Dune005/raum-tracker/Dokumentation/Arbeitsprozess_Bilder/Arbeit_am_Projekt.jpg

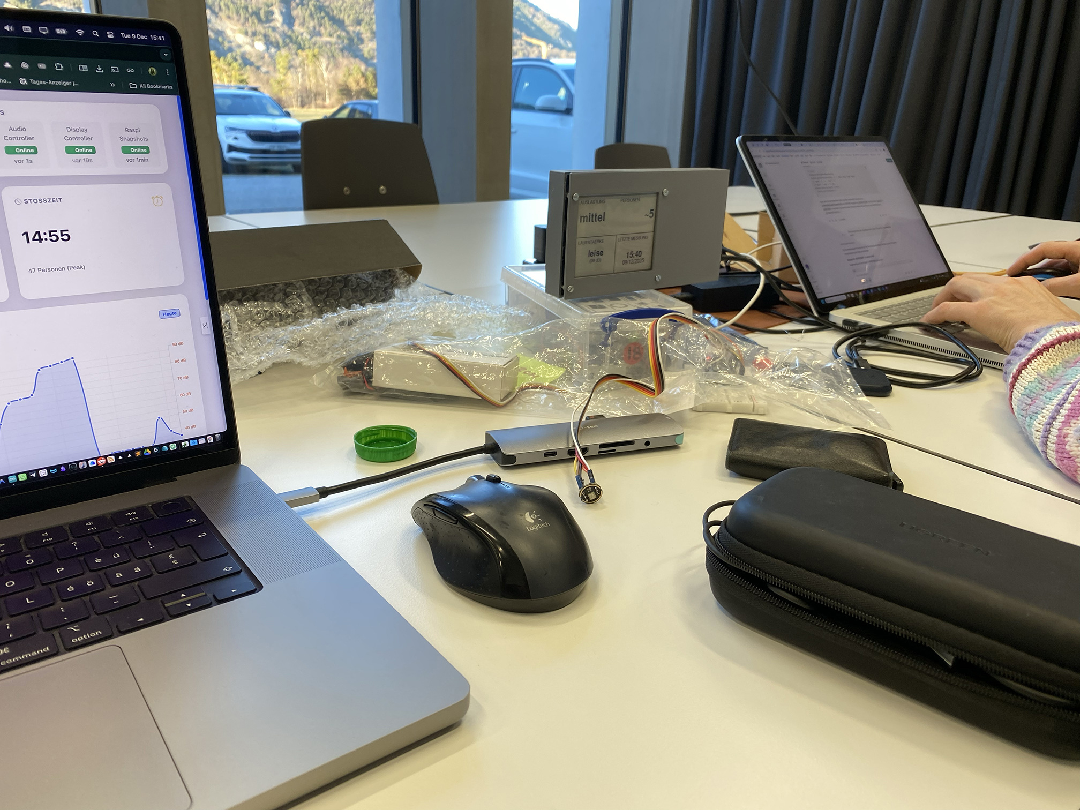
Dokumentation/Arbeitsprozess_Bilder/Arbeit_am_Projekt.jpg
