Dune005/raum-tracker/Dokumentation/Arbeitsprozess_Bilder/display1.jpeg

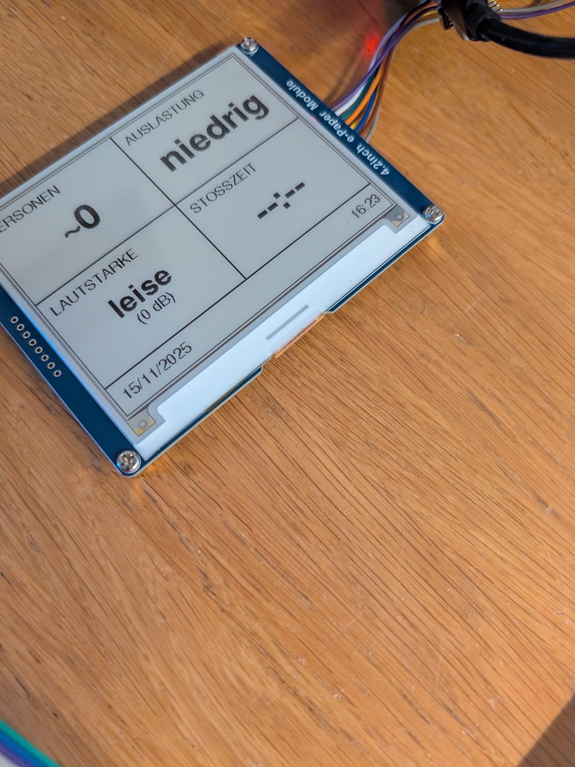
Dokumentation/Arbeitsprozess_Bilder/display1.jpeg
