Dune005/raum-tracker/Dokumentation/Arbeitsprozess_Bilder/display2.jpeg

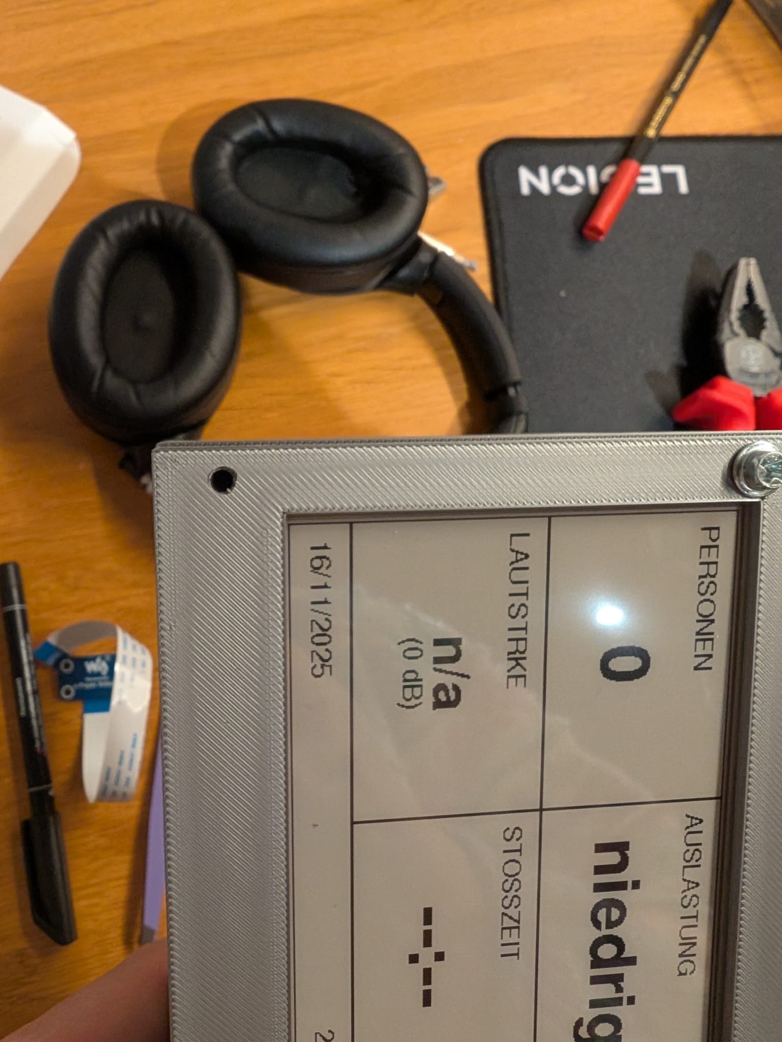
Dokumentation/Arbeitsprozess_Bilder/display2.jpeg
