Dune005/raum-tracker/Dokumentation/Arbeitsprozess_Bilder/display3.jpeg

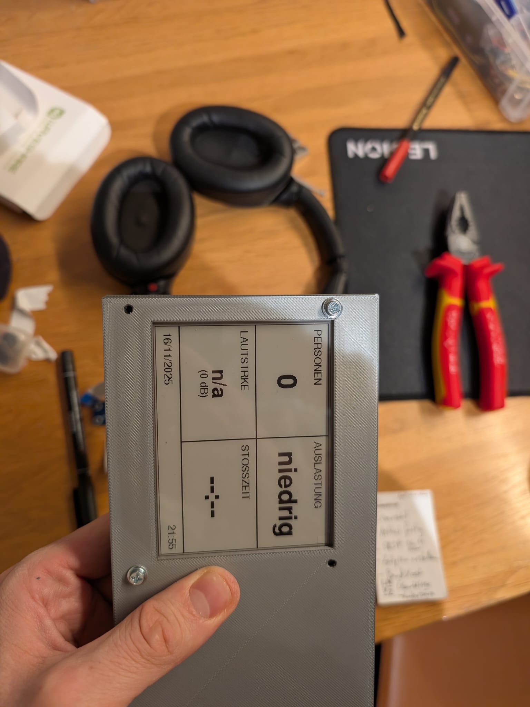
Dokumentation/Arbeitsprozess_Bilder/display3.jpeg
