Dune005/raum-tracker/Dokumentation/Arbeitsprozess_Bilder/display4.jpeg

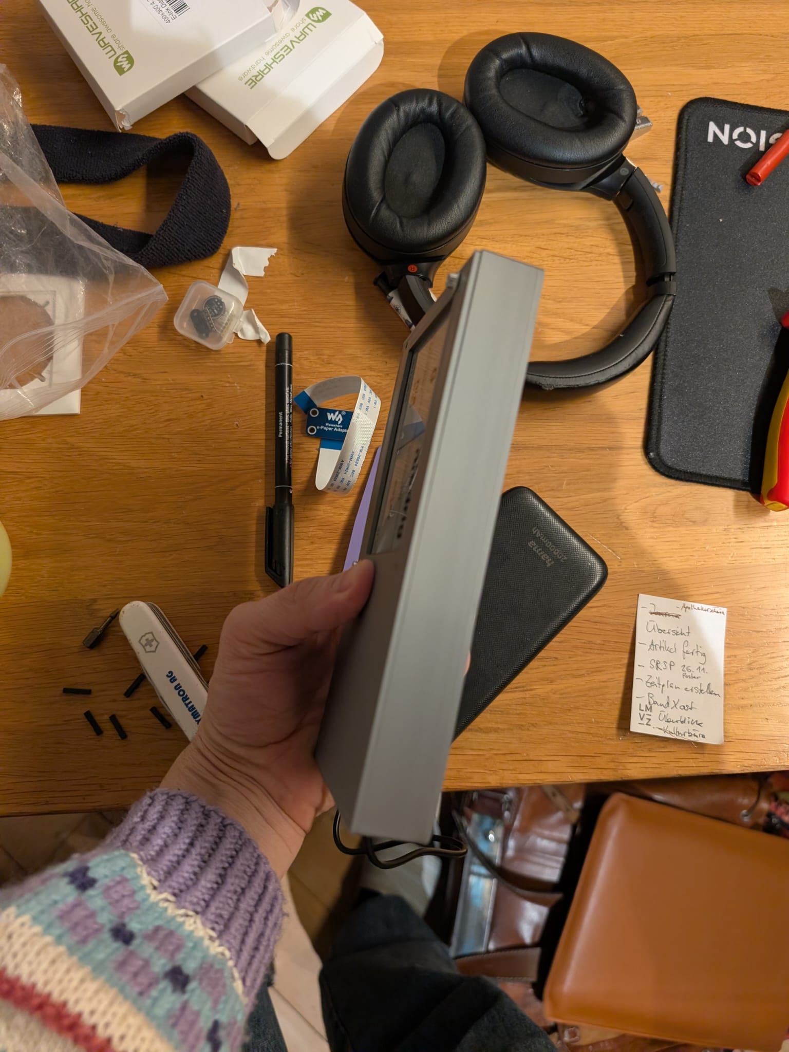
Dokumentation/Arbeitsprozess_Bilder/display4.jpeg
