Dune005/raum-tracker/Dokumentation/Arbeitsprozess_Bilder/display_COMPR.jpg

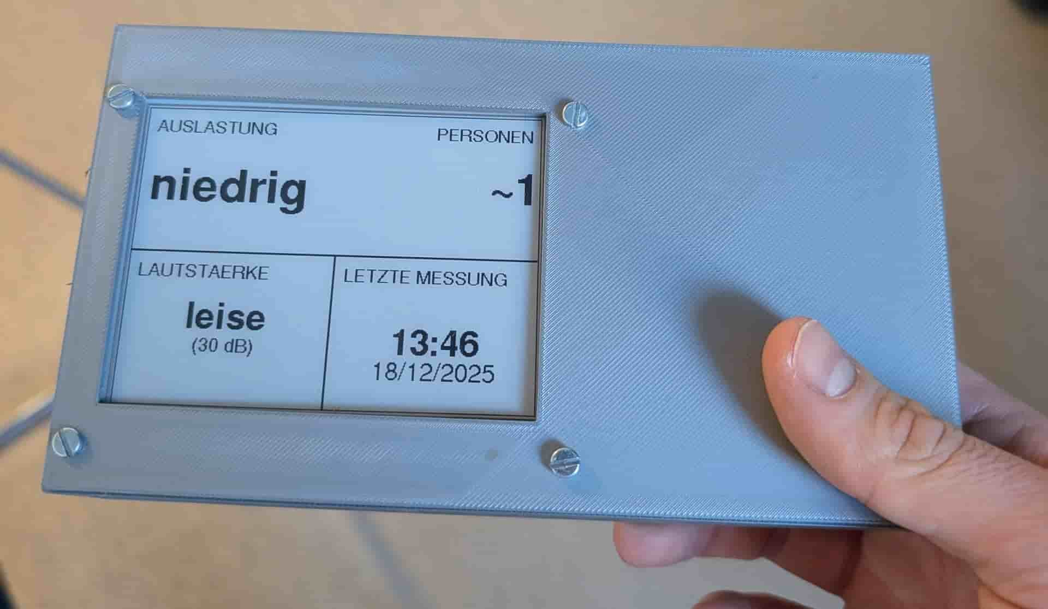
Dokumentation/Arbeitsprozess_Bilder/display_COMPR.jpg
