Dune005/raum-tracker/Dokumentation/Arbeitsprozess_Bilder/Display_IB.jpeg

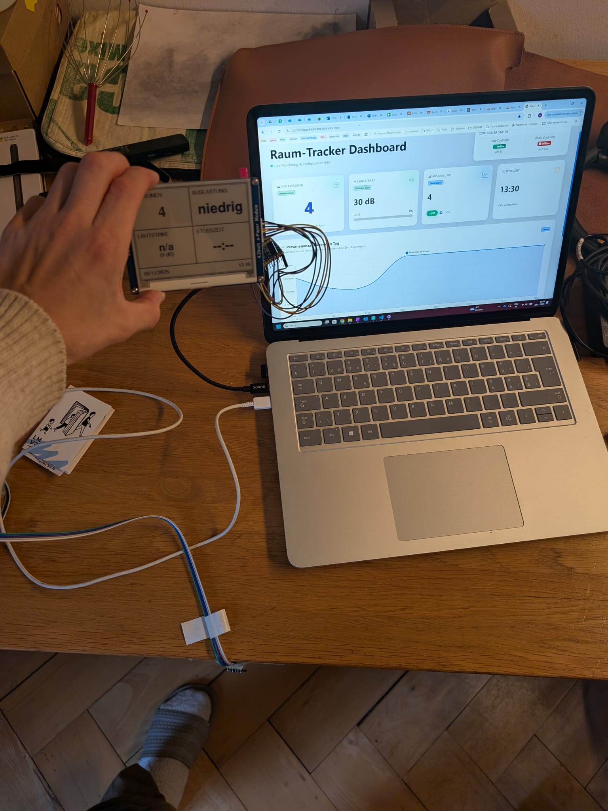
Dokumentation/Arbeitsprozess_Bilder/Display_IB.jpeg
