Dune005/raum-tracker/Dokumentation/Arbeitsprozess_Bilder/display_mit_gehaeuse.jpeg

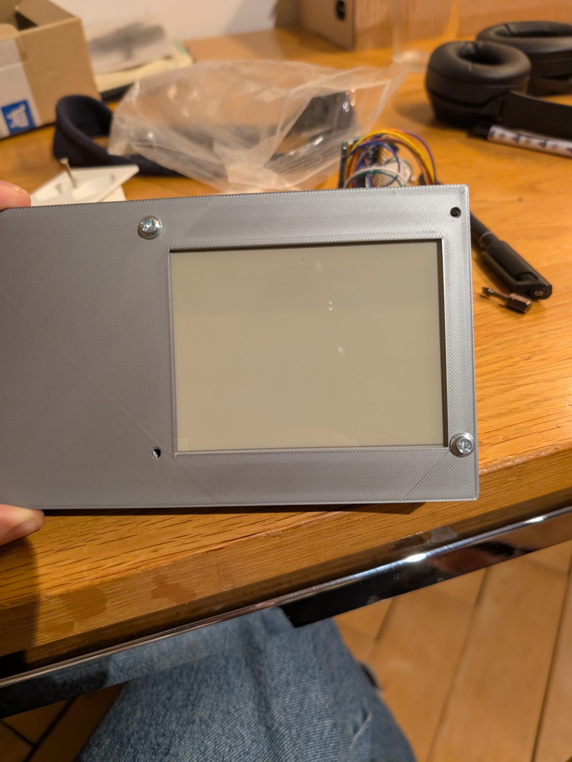
Dokumentation/Arbeitsprozess_Bilder/display_mit_gehaeuse.jpeg
