Dune005/raum-tracker/Dokumentation/Arbeitsprozess_Bilder/Entwickler_Dashboard_031225.png

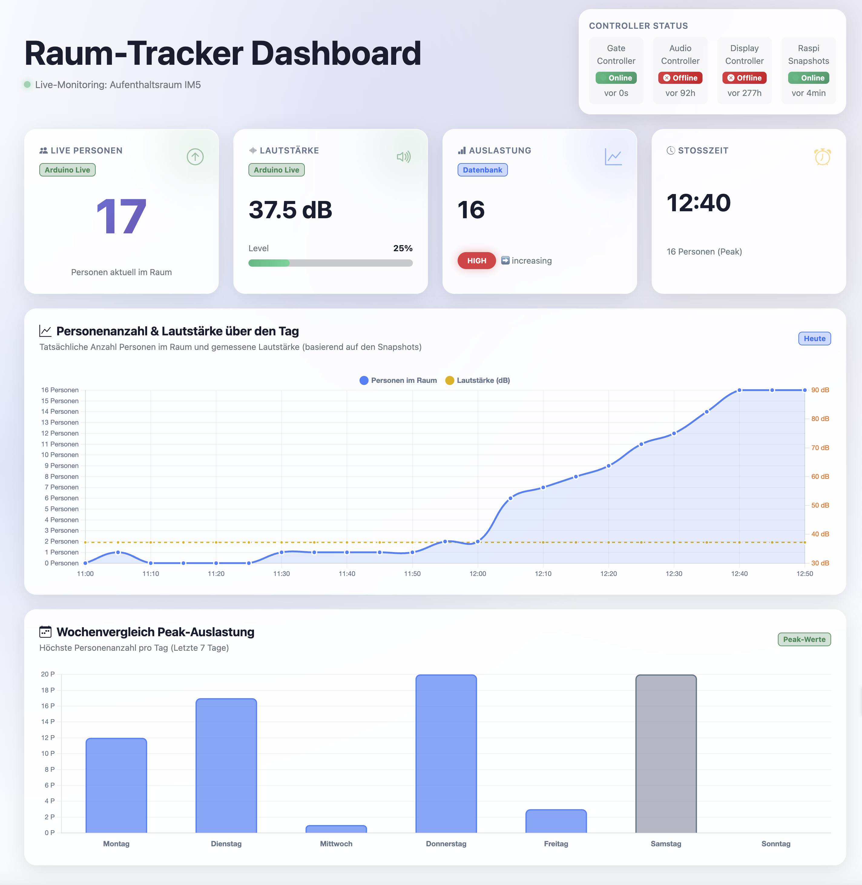
Dokumentation/Arbeitsprozess_Bilder/Entwickler_Dashboard_031225.png
