Dune005/raum-tracker/Dokumentation/Arbeitsprozess_Bilder/Entwickler_Dashboard_111225.png

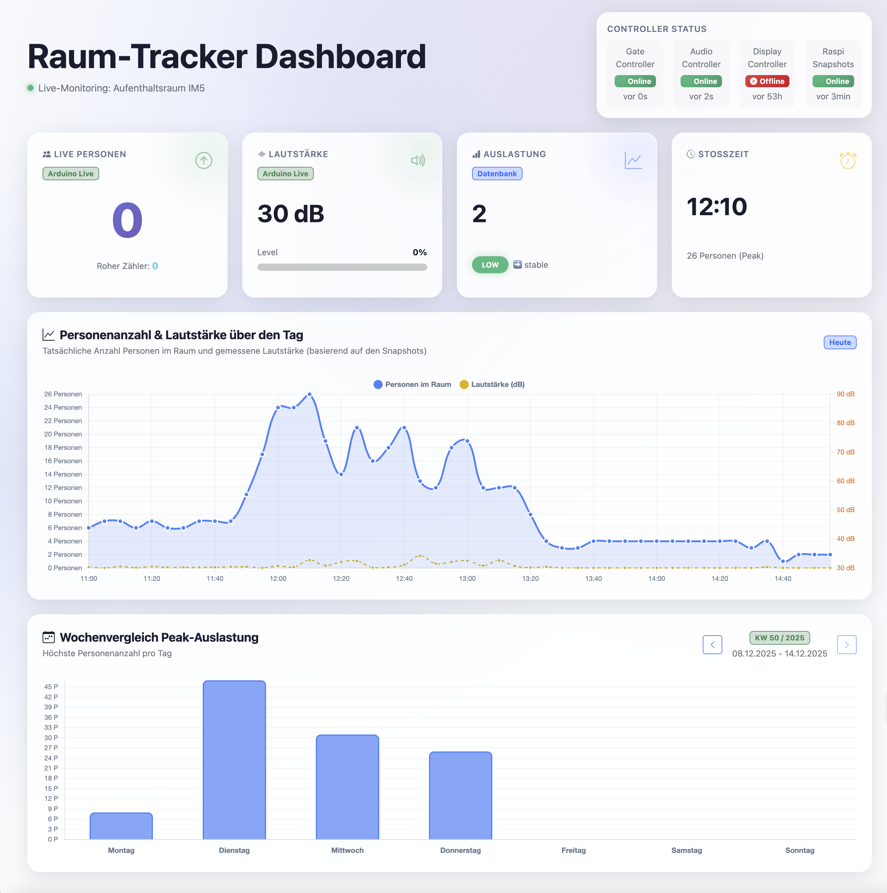
Dokumentation/Arbeitsprozess_Bilder/Entwickler_Dashboard_111225.png
