Dune005/raum-tracker/Dokumentation/Arbeitsprozess_Bilder/Lichtschranke2_ESP32C6_COMPR.jpg

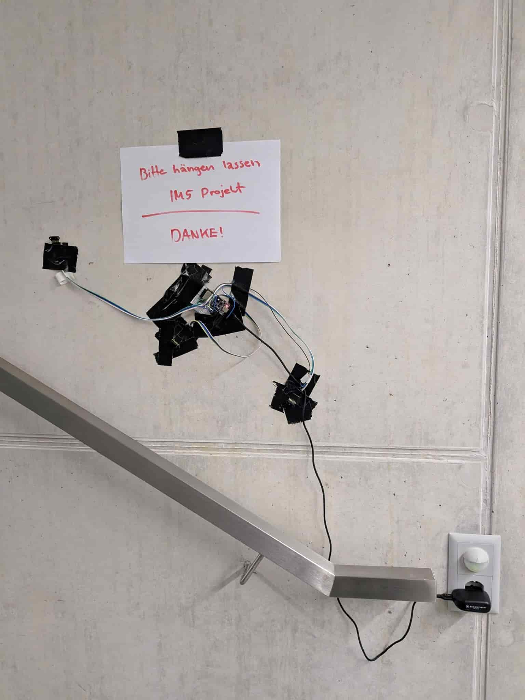
Dokumentation/Arbeitsprozess_Bilder/Lichtschranke2_ESP32C6_COMPR.jpg
