Dune005/raum-tracker/Dokumentation/Arbeitsprozess_Bilder/Lichtschranke.jpeg

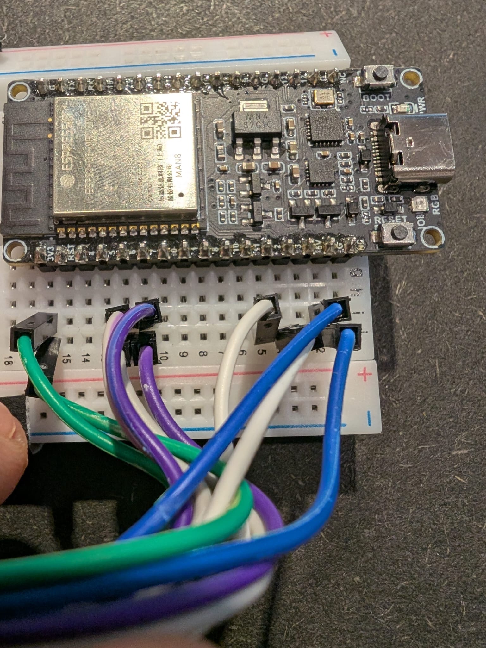
Dokumentation/Arbeitsprozess_Bilder/Lichtschranke.jpeg
