Dune005/raum-tracker/Dokumentation/Arbeitsprozess_Bilder/Loeten2_COMPR.jpg

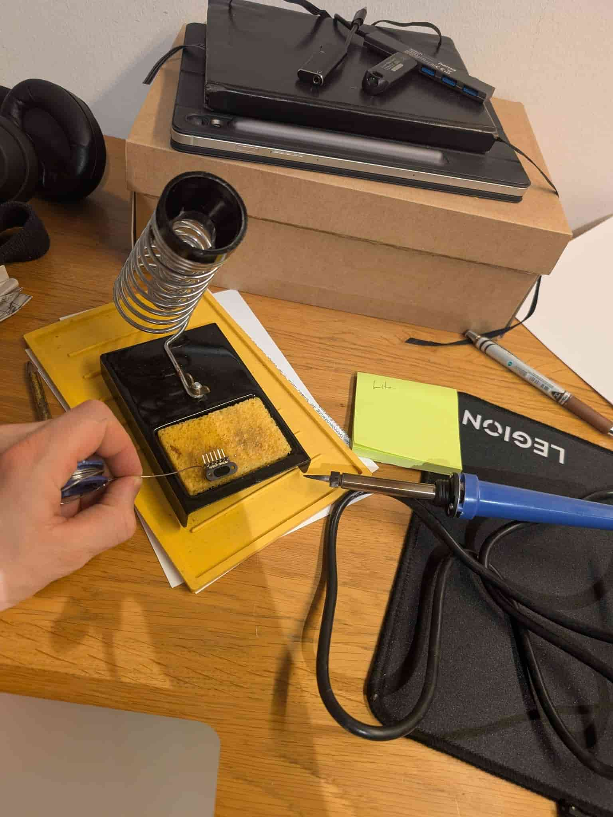
Dokumentation/Arbeitsprozess_Bilder/Loeten2_COMPR.jpg
