Dune005/raum-tracker/Dokumentation/Arbeitsprozess_Bilder/Loeten3_COMPR.jpg

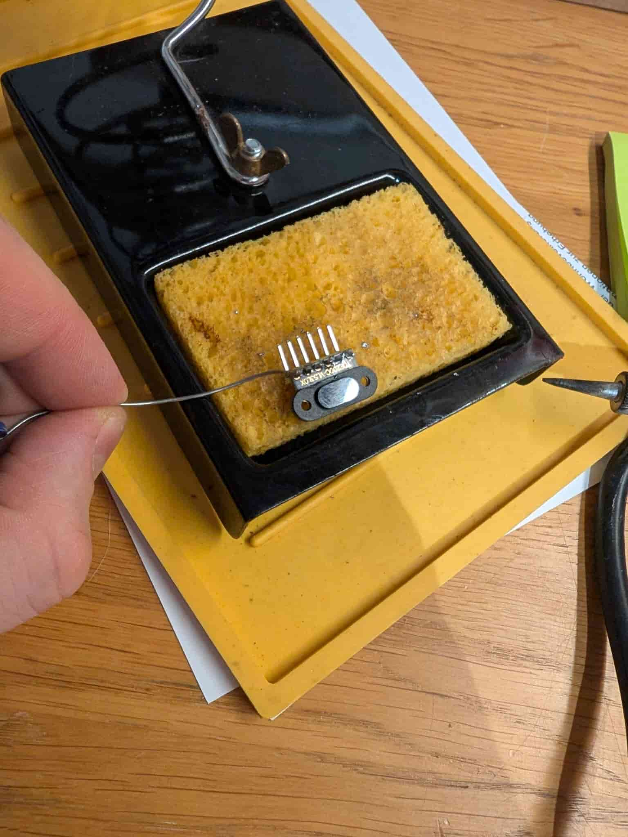
Dokumentation/Arbeitsprozess_Bilder/Loeten3_COMPR.jpg
