Dune005/raum-tracker/Dokumentation/Arbeitsprozess_Bilder/Loeten4.jpeg

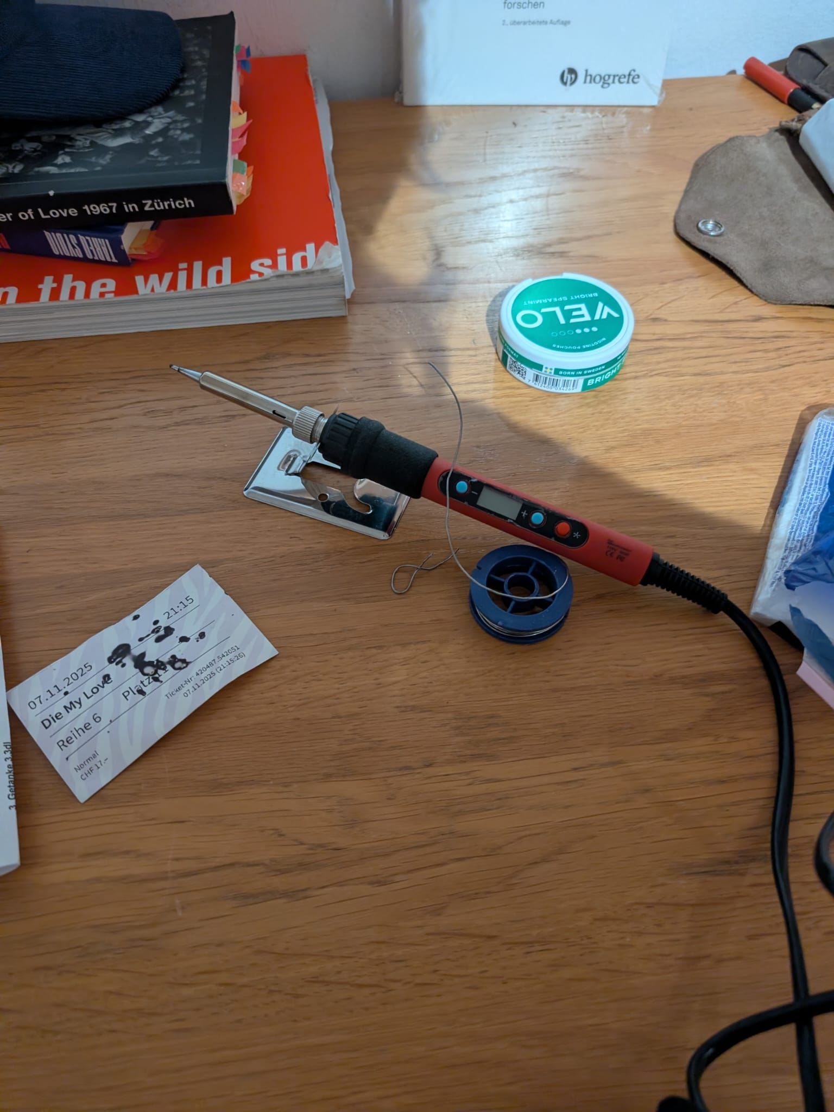
Dokumentation/Arbeitsprozess_Bilder/Loeten4.jpeg
