Dune005/raum-tracker/Dokumentation/Arbeitsprozess_Bilder/Loeten_COMPR.jpg

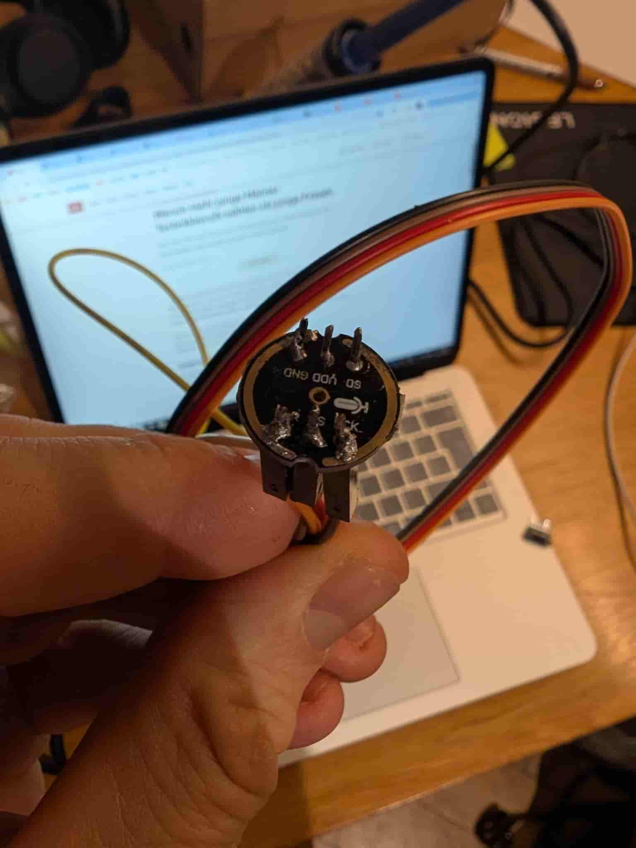
Dokumentation/Arbeitsprozess_Bilder/Loeten_COMPR.jpg
