Dune005/raum-tracker/Dokumentation/Arbeitsprozess_Bilder/Mikro_COMPR.jpg

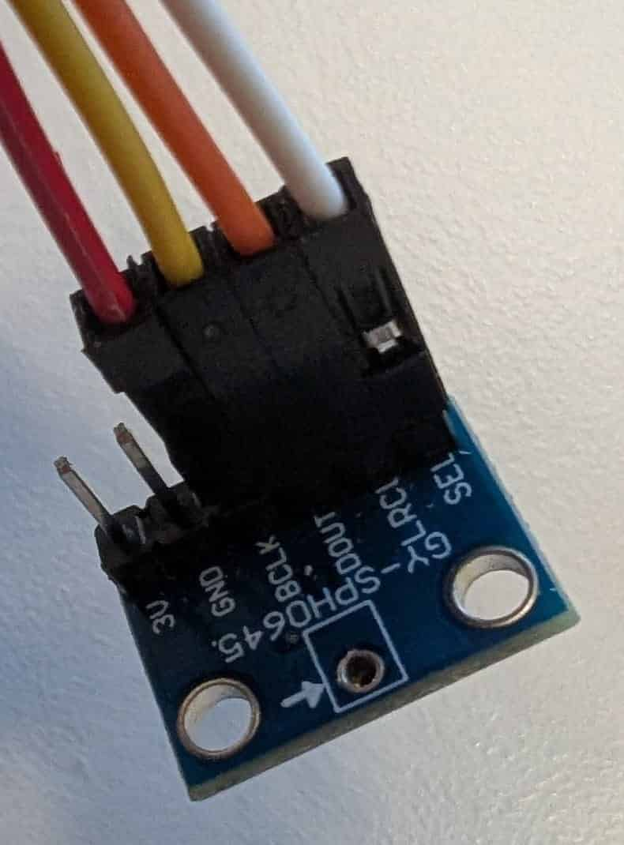
Dokumentation/Arbeitsprozess_Bilder/Mikro_COMPR.jpg
