Dune005/raum-tracker/Dokumentation/Arbeitsprozess_Bilder/Mikro_ESP32C6_COMPR.jpg

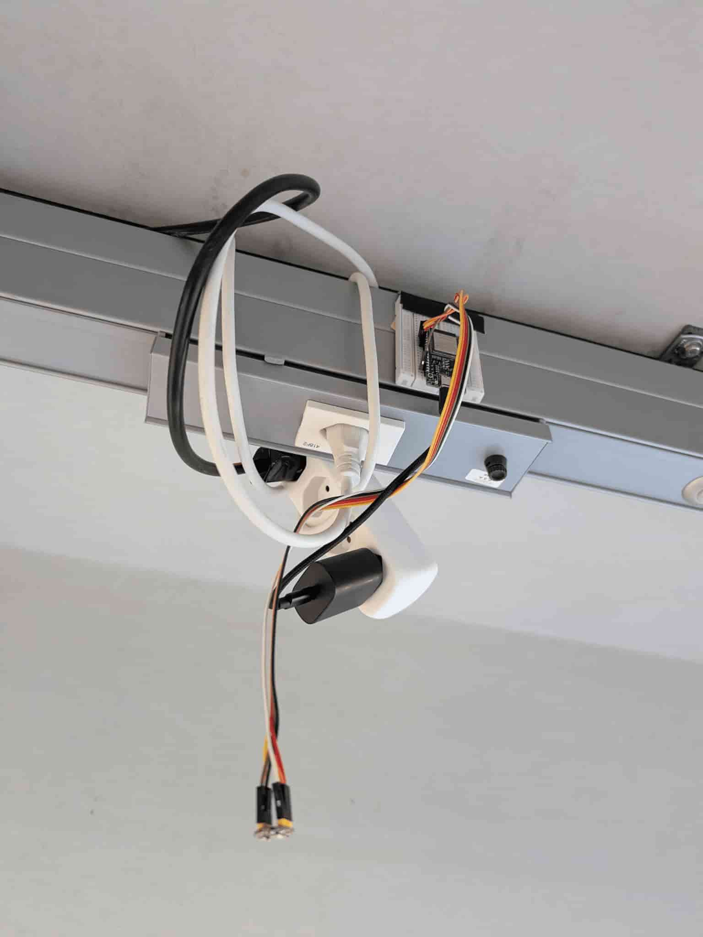
Dokumentation/Arbeitsprozess_Bilder/Mikro_ESP32C6_COMPR.jpg
