Dune005/raum-tracker/Dokumentation/Arbeitsprozess_Bilder/Screenshot_Display_Gehaeuse.jpg

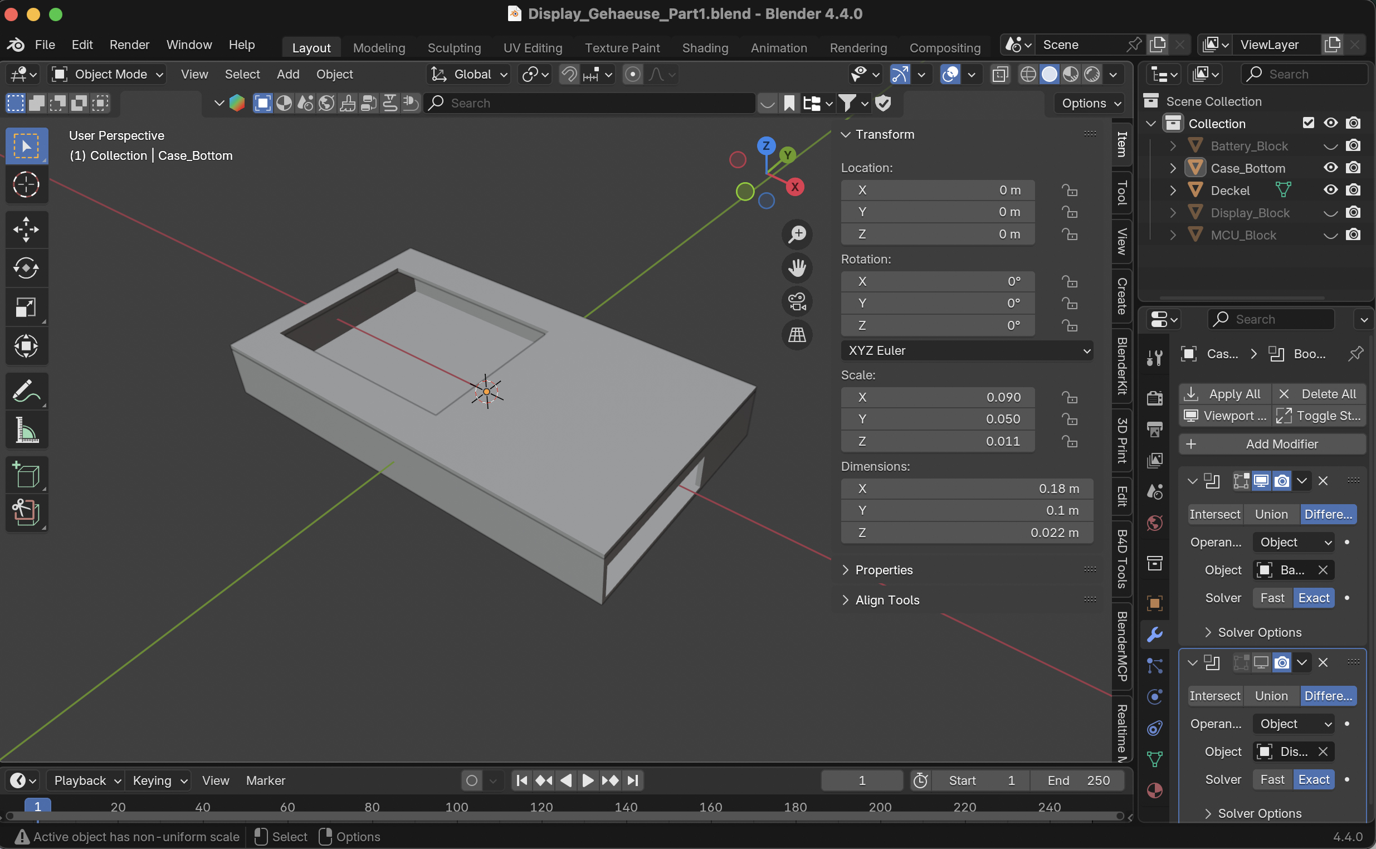
Dokumentation/Arbeitsprozess_Bilder/Screenshot_Display_Gehaeuse.jpg
