Dune005/raum-tracker/Dokumentation/Bilder/raum_tracker_mermaid.jpg

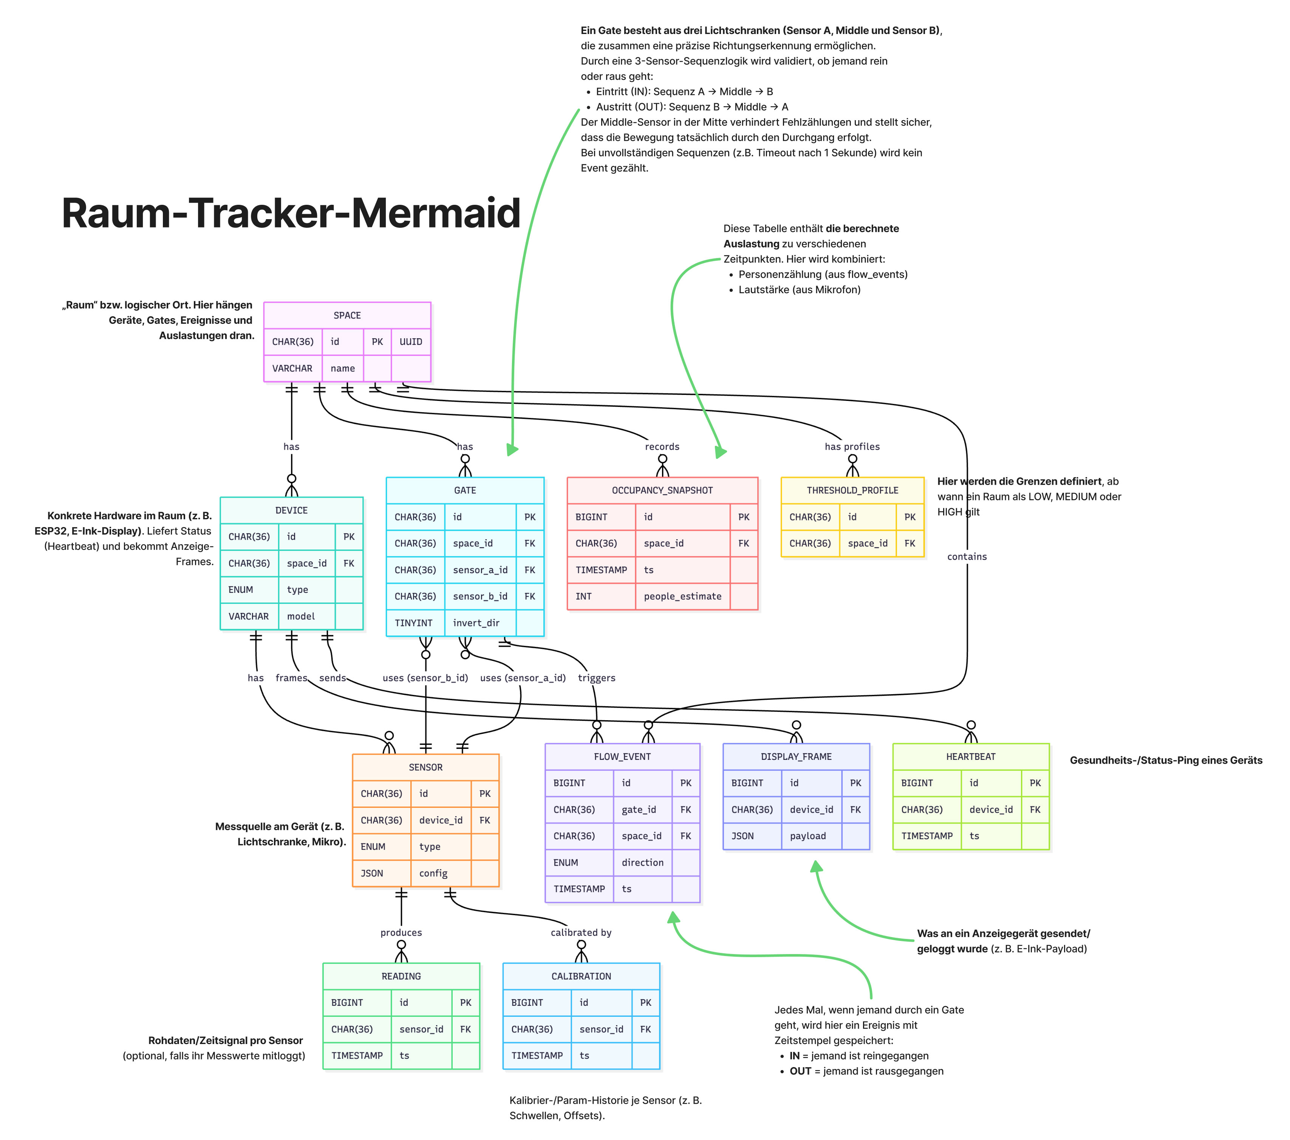
Dokumentation/Bilder/raum_tracker_mermaid.jpg
