Dune005/raum-tracker/Dokumentation/steckplaene/esp32-c6-devkitc-1-pin-layout_COMPR.jpg

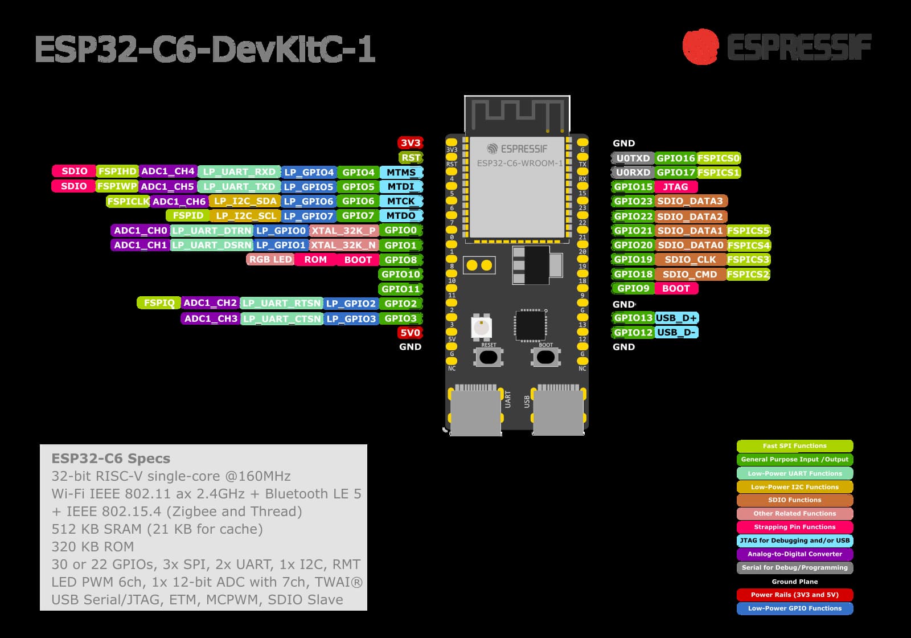
Dokumentation/steckplaene/esp32-c6-devkitc-1-pin-layout_COMPR.jpg
