Dune005/raum-tracker/Dokumentation/steckplaene/ESP32_driver_pin_plan_COMPR.jpg

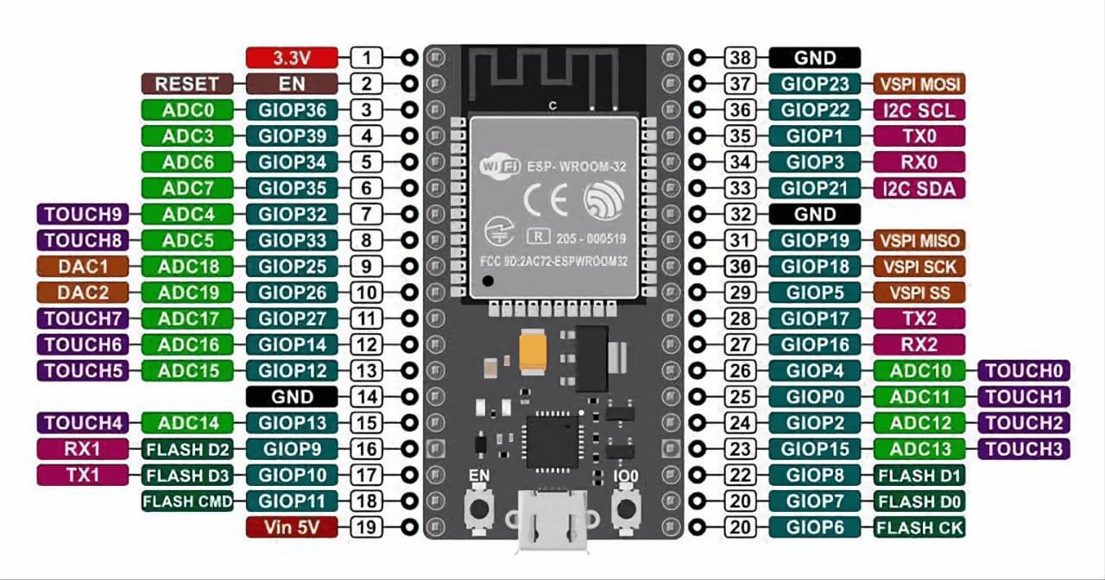
Dokumentation/steckplaene/ESP32_driver_pin_plan_COMPR.jpg
