Dune005/raum-tracker/Dokumentation/steckplaene/fotos/Display_ESP32C6_COMPR.jpg

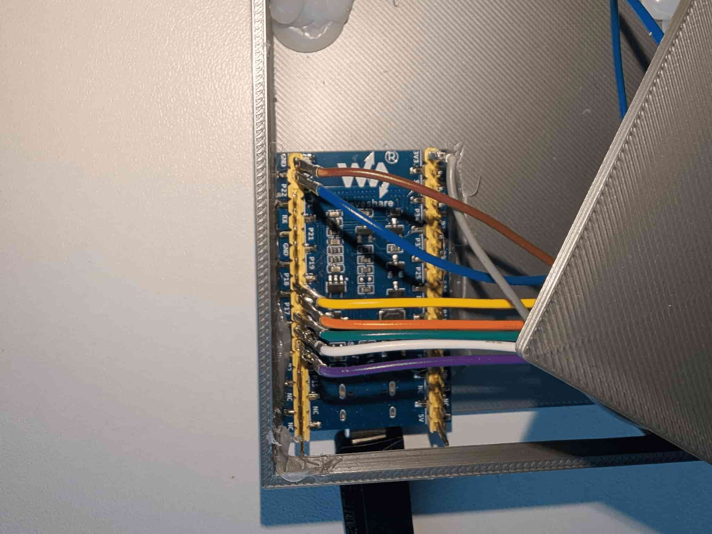
Dokumentation/steckplaene/fotos/Display_ESP32C6_COMPR.jpg
