Dune005/raum-tracker/Dokumentation/steckplaene/fotos/Lichtschranke4_ESP32C6_COMPR.jpg

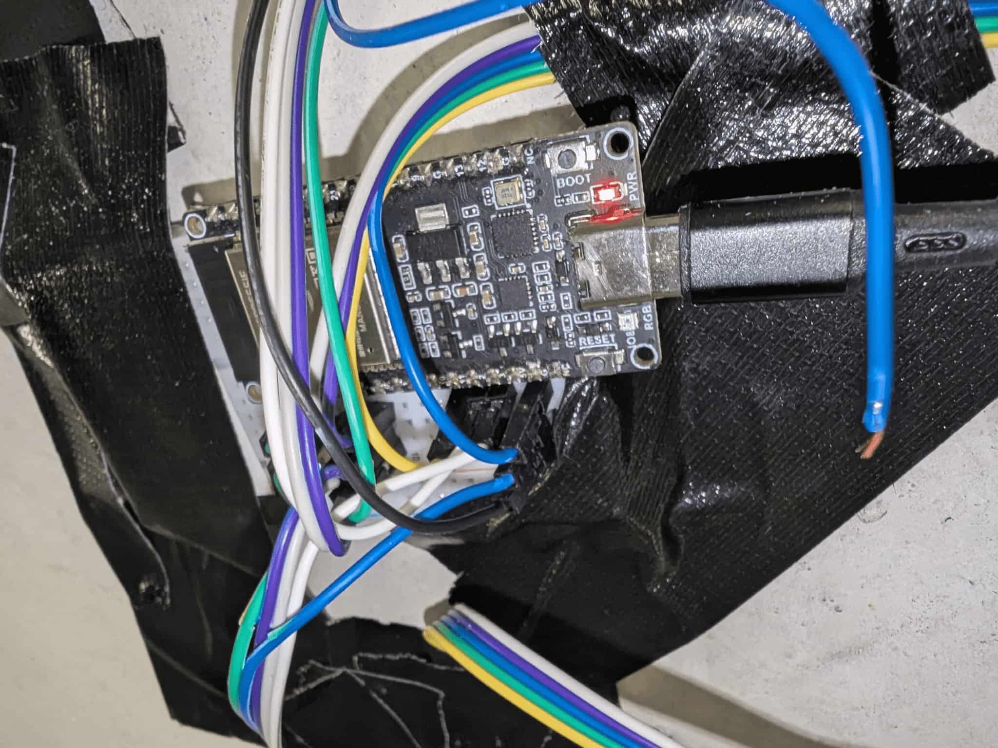
Dokumentation/steckplaene/fotos/Lichtschranke4_ESP32C6_COMPR.jpg
