Dune005/raum-tracker/Dokumentation/steckplaene/fotos/Lichtschranke_ESP32C6_COMPR.jpg

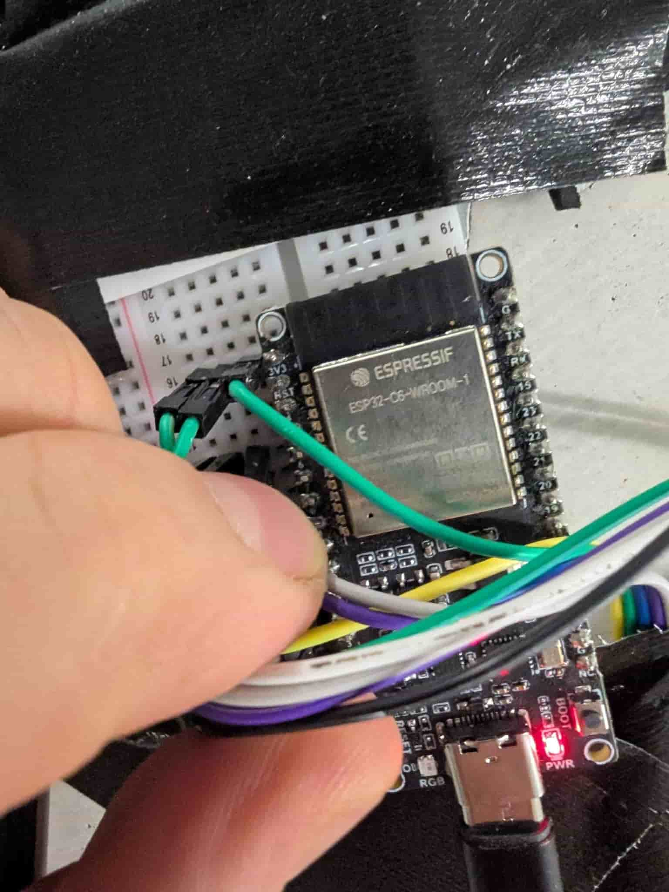
Dokumentation/steckplaene/fotos/Lichtschranke_ESP32C6_COMPR.jpg
