Dune005/raum-tracker/Dokumentation/steckplaene/fotos/Mikro2_ESP32C6_COMPR.jpg

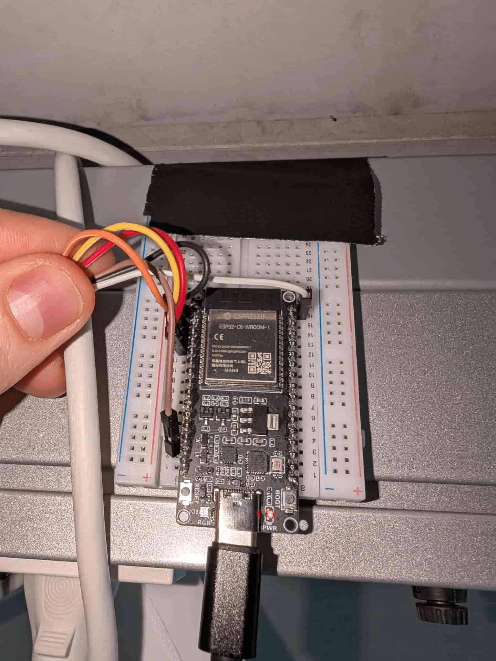
Dokumentation/steckplaene/fotos/Mikro2_ESP32C6_COMPR.jpg
