Dune005/raum-tracker/Dokumentation/Arbeitsprozess_Bilder/Installation.jpg

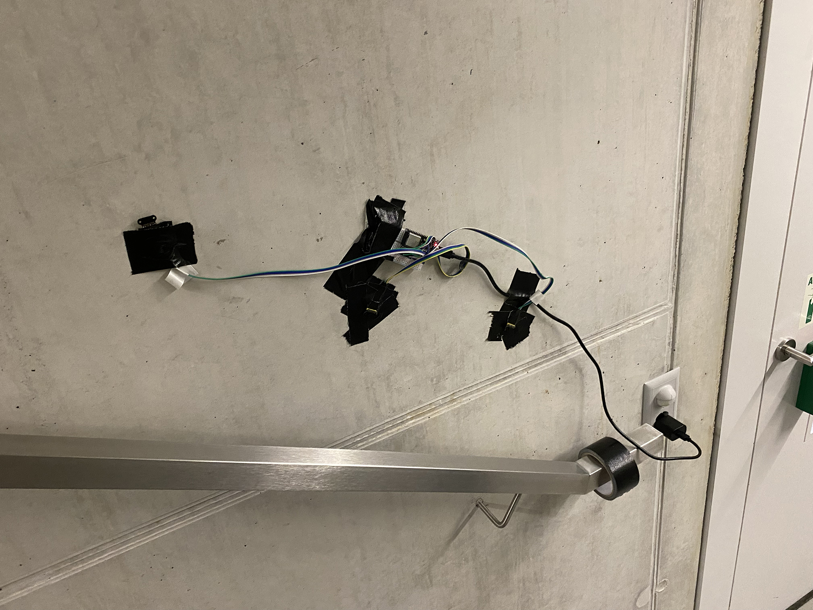
Dokumentation/Arbeitsprozess_Bilder/Installation.jpg
