Dune005/raum-tracker/Dokumentation/Arbeitsprozess_Bilder/test.jpeg

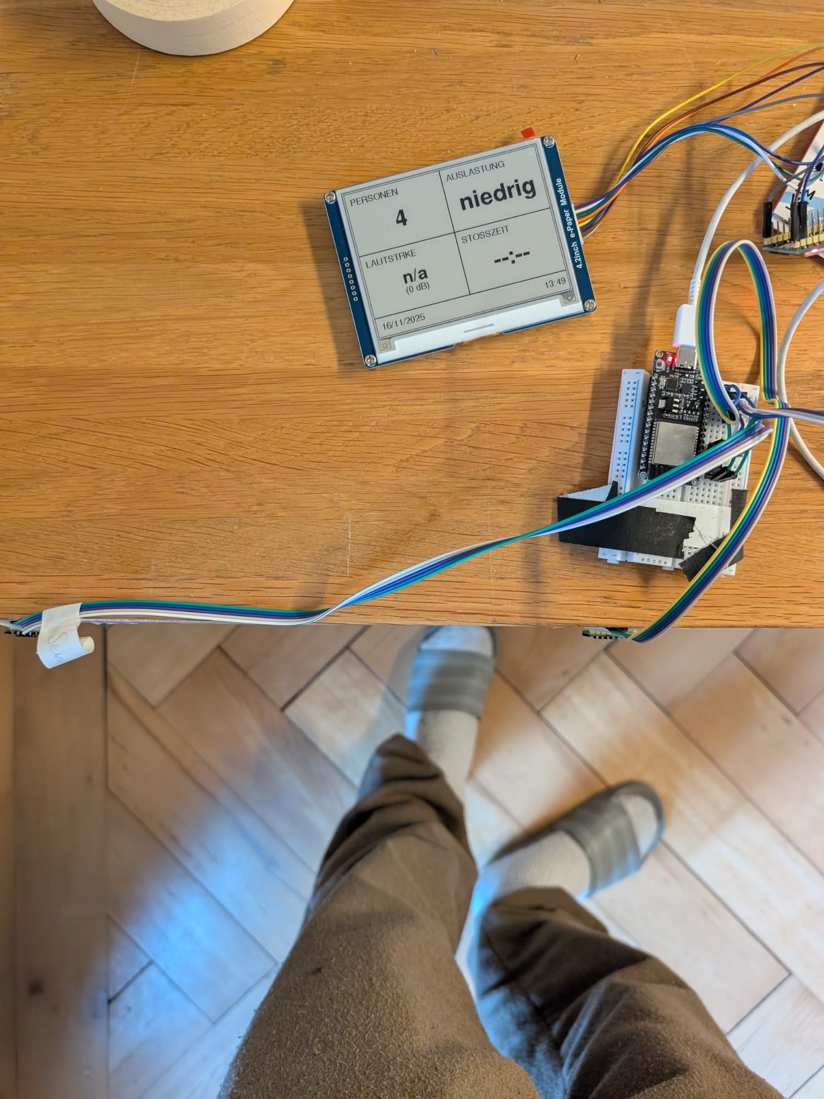
Dokumentation/Arbeitsprozess_Bilder/test.jpeg
