Dune005/raum-tracker/(commit log)

2025-10-22 🚀 Projektinitialisierung mit erster Backend-Struktur
2025-10-27 Aktualisierung hybrides Dashboard
    Personenzähler und Live-Lautstärke werden nun von getrennten Boards abgerufen und angezeigt. Nur die Live-Anzeige ist aktuell. Datenbank Informationen sind noch Dummy-Infos und werden erst später benötigt.
2025-11-10 aktuelle arduino codes und Dashboard Anpassungen
2025-11-11 cron job Einrichtung und Dashboard Optimierungen
2025-11-11 PIR Sensor aus Projekt entfernt
2025-11-13 Dashboard Anpassungen und neue Sketches
2025-11-27 Aktuelle Codes
    - Alle 3 Boards haben nun funktionierende Codes
    - Mikro Board momentan noch im Igloo Wifi
2025-11-27 Dokumentation und Dashboard Anpassungen
    Die Dokumentation wurde ergänzt und ein Mermaid-Diagramm eingefügt. Das Dashboard wurde ergänzt, damit jetzt auch der Online-Status vom Raspberry Pi angezeigt wird.
2025-11-28 Dashboard und Display Integration
    Das Dashboard wurde um die Dezibel-Anzeige im täglichen Chart erweitert. Zusätzlich sind jetzt alle Controller mit Online-Status sichtbar.
2025-12-08 paar neue bzw geupdatete Files
    und die alten sind in den alten codes drin
2025-12-26 Readme und Bilder aktualisiert
2026-01-02 Kosmetik
    Bissl aufgeräumt und umbenannt
